Aliceykr/bot/game/game_runtime.c

#include "game_runtime.h"
#include "rom_loader.h"
#include "gb_emu.h"
#include "game_2048.h"
#include "game_dice.h"
#include <string.h>
#include "freertos/FreeRTOS.h"
#include "freertos/task.h"
#include "esp_log.h"
#include "lcd.h"

#define TAG "GAME_RT"

/* 内置游戏（非 ROM）使用的特殊 rom_name 前缀。
 * ROM 列表传入这些名字时不走 SPIFFS 加载，直接调对应的内置游戏。 */
#define BUILTIN_2048_NAME "__builtin_2048"
#define BUILTIN_DICE_NAME "__builtin_dice"

void game_runtime_request_exit(void)
{
    /* 统一退出入口：当前可能运行的是 GB 模拟器、2048 或骰子。
     * 各模块自己检查退出标志，未运行的模块收到请求也没有副作用。 */
    gb_emu_request_exit();
    game_2048_request_exit();
    game_dice_request_exit();
}

void game_runtime_run(const char *rom_name)
{
    /* 运行时只做分派和 ROM 加载，不负责 LVGL suspend/resume。
     * 调用方已经接管屏幕和输入，因此这里可以直接使用 LCD 底层绘制。 */
    /* 内置游戏分派：不走 SPIFFS，直接跑对应的实现。
     * 以后加新内置游戏（推箱子、贪吃蛇等）只需要在此处加分支。 */
    if (rom_name && strcmp(rom_name, BUILTIN_2048_NAME) == 0) {
        ESP_LOGI(TAG, "启动内置 2048");
        game_2048_run();
        return;
    }
    if (rom_name && strcmp(rom_name, BUILTIN_DICE_NAME) == 0) {
        ESP_LOGI(TAG, "启动内置摇骰子");
        game_dice_run();
        return;
    }

    /* 先显示一个加载画面 */
    LCD_Fill(0, 0, LCD_W, LCD_H, 0x0000);
    LCD_ShowString(4, 20, (const uint8_t *)"Loading ROM...", 0xFFFF, 0x0000, 16, 0);
    if (rom_name) {
        LCD_ShowString(4, 40, (const uint8_t *)rom_name, 0x07FF, 0x0000, 16, 0);
    }

    /* 加载 ROM 到 PSRAM */
    size_t rom_size = 0;
    void *rom = rom_loader_read(rom_name, &rom_size);
    if (!rom) {
        LCD_ShowString(4, 80, (const uint8_t *)"ROM load FAILED",
                       0xF800, 0x0000, 16, 0);
        vTaskDelay(pdMS_TO_TICKS(2000));
        return;
    }

    ESP_LOGI(TAG, "ROM 加载 %u 字节，启动 Walnut-CGB", (unsigned)rom_size);

    /* 退出键监控由矩阵键盘模块内部完成（中间键长按 800ms）。
     * gb_emu 主循环每帧会调 keypad_consume_exit_request 检测。
     * 不再需要独立 watcher_task。*/

    bool ok = gb_emu_run((const uint8_t *)rom, rom_size);

    rom_loader_free(rom);

    if (!ok) {
        LCD_Fill(0, 0, LCD_W, LCD_H, 0x0000);
        LCD_ShowString(4, 20, (const uint8_t *)"Emulator init failed",
                       0xF800, 0x0000, 16, 0);
        LCD_ShowString(4, 40, (const uint8_t *)"ROM may be invalid.",
                       0xFFFF, 0x0000, 16, 0);
        LCD_ShowString(4, 60, (const uint8_t *)"Hold center key to exit.",
                       0x07FF, 0x0000, 16, 0);
        /* 失败场景下等用户按中间键退出（短按即退，2 秒超时兜底）*/
        vTaskDelay(pdMS_TO_TICKS(2000));
    }

    ESP_LOGI(TAG, "game_runtime_run 退出");
}
