Aliceykr/bot/user/wifi.h

#ifndef __WIFI_H
#define __WIFI_H

#include <stdint.h>
#include <stdbool.h>
#include <stddef.h>

// WiFi 连接状态
typedef enum {
    WIFI_STATUS_DISCONNECTED = 0,
    WIFI_STATUS_CONNECTING,
    WIFI_STATUS_CONNECTED,
    WIFI_STATUS_FAILED,
    WIFI_STATUS_RECONNECTING,  /* 运行期断线，后台守护任务正在退避重连 */
} wifi_status_t;

// WiFi 配置，修改为你的路由器信息
#define WIFI_SSID      "11111111"
#define WIFI_PASSWORD  "22222222"
#define WIFI_MAX_RETRY 10

/* wifi_set_credentials：更新 STA 连接使用的 SSID/密码。
 *
 * 主要给 BLE 配网回调使用；如果 WiFi 已初始化，会同步刷新驱动配置。
 * 下次 wifi_connect / 自动重连将使用新凭据。 */
void wifi_set_credentials(const char *ssid, const char *password);

/* wifi_connect：初始化 WiFi STA 并阻塞等待连接结果。
 *
 * 首次成功后会启动守护任务；后续运行期断线由守护任务指数退避重连。
 * 返回 true 表示本次连接拿到 IP，false 表示超时或驱动启动失败。 */
bool wifi_connect(void);

/* wifi_disconnect：用户主动断开 WiFi 并停止守护重连。
 *
 * 与运行期断线不同，此函数会设置 user_stopped，守护任务不会自动拉起连接。 */
void wifi_disconnect(void);

/* wifi_get_status：读取当前 WiFi 状态快照。
 *
 * 高频 UI/HTTP 守卫使用的无锁读取；只保证最终一致，不适合读取 IP 字符串。 */
wifi_status_t wifi_get_status(void);

// 将当前 IP 地址以稳定快照方式 copy 进 out（\0 结尾），最多 cap-1 字符。
// 内部持锁读取，避免事件回调并发改写时读到撕裂字符串。
// cap 必须 >= 1；cap=0 时什么都不做。
void wifi_copy_ip(char *out, size_t cap);

/* 游戏模式：完整停止 WiFi 并阻止守护任务重连，腾出所有 WiFi 内部 DRAM。
 * 不释放 WiFi 子系统配置（下次 resume 直接用），仅 stop（发断开 + 释放 buffer）。
 * 比 esp_wifi_stop 多做了：挡住守护任务，避免它立即重连回来。 */
void wifi_suspend_for_game(void);

/* 游戏结束后恢复 WiFi（异步，立即返回）。 */
void wifi_resume_after_game(void);

/* 蓝牙互斥模式：完整关闭 WiFi（包括 esp_wifi_deinit），腾出 ~30KB 连续 DRAM
 * 给 BLE controller。调用后 wifi_connect 会重新走完整 init 流程。
 * 用于"开蓝牙时关闭 WiFi"场景。 */
void wifi_full_shutdown_for_ble(void);

#endif
