Aliceykr/bot/(commit log)

2026-03-21 初版，测试了lcd（带字库）
2026-03-21 修改了架构
2026-03-21 整合了lcd驱动，简化了工程结构
2026-03-21 修复了一些bug
2026-03-21 修复了小bug
2026-03-21 添加了readme介绍
2026-03-21 添加了wifi链接功能
2026-03-21 更换了lcd屏幕，去掉了字库，使其更具有普适性
2026-03-21 换成了硬件spi，提高了lcd刷新速度
2026-03-21 移植了lvgl，但是lvgl色彩还是有问题
    [partitions.csv]
2026-03-21 修复了lvgl色彩问题，加入了编码器控制lvgl界面
2026-03-21 完善了wifi连接按键功能
2026-03-21 添加了天气查询功能，但中文字库还未添加导致显式问题
2026-03-21 天气与日期功能基本完善，但是图标问题和连接了wifi后再按一次wifi连接会崩溃，待完善
    [partitions.csv]
2026-03-22 修复了一些问题
2026-03-22 修复了wifi加载问题
2026-03-22 去掉了时钟显示
2026-03-22 添加了ntp时间校准功能，重新添加了时间显示
2026-03-22 首页图标修复
2026-03-22 添加了ai聊天功能
2026-03-22 完善了聊天界面
2026-03-22 修复了聊天界面堆栈不足的问题
2026-03-22 修复了内存泄漏的问题，但还有弹窗动画卡顿问题
2026-03-23 inmp441录音功能修复，添加了usb接收麦克风录音数据来测试麦克风是否正常的功能
2026-03-24 修复了弹窗问题，规范了mydemo的代码
2026-03-24 修复了弹窗问题，规范了lvgldemo的代码
2026-03-24 修复了一些问题，但改成了全屏刷新
2026-03-24 readme文档更新
2026-03-24 修复了语音识别的问题
2026-03-24 连接上了语音识别和模型回复
2026-03-24 更新readme
2026-03-24 增加了语音合成功能
2026-03-24 去掉了首页显示bug，修复了tts的内存bug
2026-03-24 更新了文档
2026-04-23 修复了lvgl拉取功能
2026-04-23 修正了代码，去掉了测试部分的tinyusb部分
2026-04-23 补充了lvgl部分代码
2026-05-07 初步修复
2026-05-07 换成了psram
2026-05-07 稍微加快了一点刷新速度
2026-05-07 修复了psram导致的wifi无法使用问题u
2026-05-07 减负了ram
2026-05-09 修复了代码的一些bug，提高了系统的稳定性
2026-05-09 优化了屏幕刷新逻辑
2026-05-09 初步添加了游戏功能
    [partitions.csv]
2026-05-09 优化了游戏运行，稳定60fps
2026-05-09 WiFi功能修复
2026-05-09 修复了打开wifi后游玩游戏会直接崩溃的问题
2026-05-09 增加了织梦岛
2026-05-09 修复了栈容量问题
2026-05-09 修复了按键问题
2026-05-09 修改了音频系统和按键系统和修复了游戏与音频的内存回收
2026-05-09 修复了变量问题
2026-05-09 新增 ESP-SR 离线语音命令、BLE 蓝牙配网功能，单位测试
2026-05-09 暂未测试
    [partitions.csv]
2026-05-10 修复了wifi配网的bug，修复了游戏退出时无法正确回到主界面的bug
2026-05-10 修复了按键抖动bug
2026-05-10 修复了无wifi情况下开启语音模型对话崩溃问题
2026-05-10 修复了音频问题
2026-05-10 2048游戏
2026-05-11 初步修改了音频问题
2026-05-11 更新了readme
2026-05-12 增加了sd卡
2026-05-12 修复了代码
2026-05-12 增加了音乐播放功能，将rom移动到了sd卡，增加了音量调节功能
    [partitions.csv]
2026-05-12 更新了readme文档和修复了2048游戏不显示问题
2026-05-12 新增了吧法云控制智能设备
2026-05-13 增加了后台播放音乐的功能
2026-05-13 全面修复了bug
2026-05-13 修复了图标问题
2026-05-13 更新了初版APP
2026-05-13 修复了wifi连接时开启蓝牙崩溃的问题
2026-05-14 fix: 修复多个并发安全和资源管理 bug
    - baidu_token: 新增 baidu_token_copy() 锁内拷贝，消除指针悬空风险
    - wifi: 守护任务改为协作式退出，避免 vTaskDelete 导致 mutex 死锁
    - model/weather/music: 新增 _init() 函数在 app_main 提前创建 mutex
    - psram_task: task_entry 加 taskYIELD 防止 handle 赋值竞态
    - 新增 .gitattributes 统一行尾为 LF，防止跨平台幽灵更改
    - 更新 README 文档
    [asr.c, baidu_token.c, baidu_token.h, main.c, model.c, model.h, music.c, music.h]
2026-05-14 修复了bug
2026-05-14 修复了bug1
2026-05-14 新添加了cpu6050控制2048的功能
2026-05-14 修复了mpu6050的IDF 组件依赖问题
2026-05-16 修复了倾斜逻辑
2026-05-16 添加了sr控制逻辑，修复了相关bug
2026-05-16 增加了巴法云控制功能
2026-05-16 删掉了多余的测试文件
2026-05-16 添加了多语言
2026-05-16 加入了开源协议
2026-05-17 增加了环境监测功能
2026-05-17 修复了dht11
2026-05-20 增加了语音控制智能设备的功能
2026-05-20 fix: 修复语音控制分支合并后多余的闭合括号
2026-05-22 修复了各种bug
2026-05-22 修复了音乐播放的bug
2026-05-22 添加了音色切换功能
2026-05-22 增加了摇骰子游戏
2026-05-22 文档部分
2026-05-22 增加了注释
