Aliceykr/bot/(notices)

Notices in the files:
game/walnut_cgb.h:
Taken from SameBoy, which is released under MIT Licence.
